logman00b44/KeyConnect/mechanical/pcb/previews/bottom.png

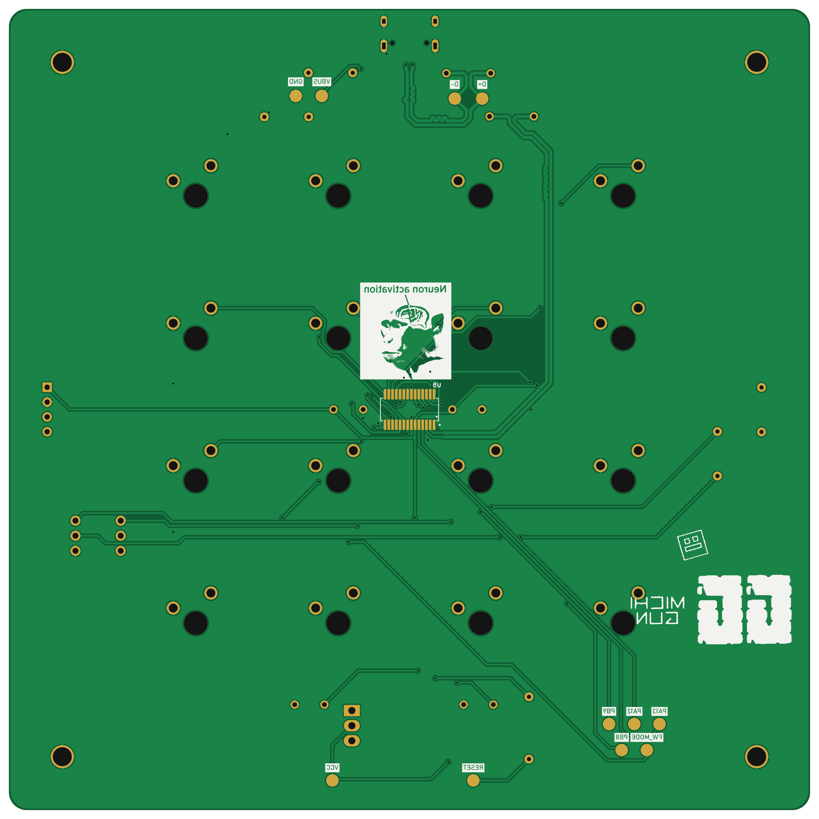
mechanical/pcb/previews/bottom.png
