logman00b44/KeyConnect/mechanical/pcb/previews/top.png

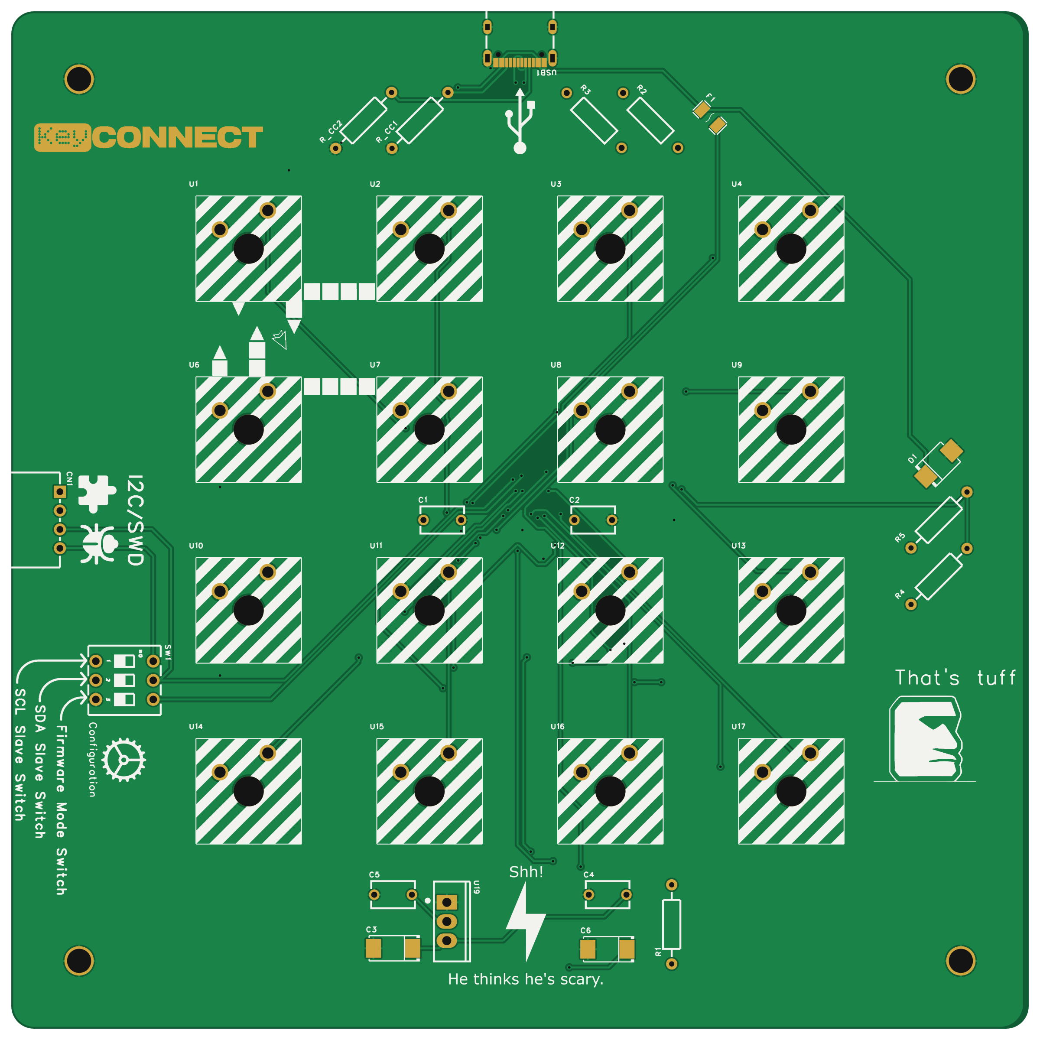
mechanical/pcb/previews/top.png
