logman00b44/KeyConnect/hardware/bom/BOM_PCB2_1.md

| Designators | Qty | Value / Part | Footprint | LCSC | Mfr Part # |
|---|---|---|---|---|---|
| `C1 C5 C4 C2` | 4 | 100nF | CAP-TH_L5.8-W3.6-P5.0-D0.6 | [C5632426](https://www.lcsc.com/product-detail/C5632426.html) | 178MU0002 |
| `C6 C3` | 2 | 47uF | CAP-SMD_L6.0-W3.2-R-RD | [C506634](https://www.lcsc.com/product-detail/C506634.html) | 593D476X9010C2TE3 |
| `CN1` | 1 | ZX-XH2.54-4PWZ | CONN-TH_4P-P2.50_ZX-XH2.54-4PWZ | [C7429643](https://www.lcsc.com/product-detail/C7429643.html) | ZX-XH2.54-4PWZ |
| `D1` | 1 | SMBJ5.0A | SMB_L4.6-W3.6-LS5.4-RD | [C50087807](https://www.lcsc.com/product-detail/C50087807.html) | SMBJ5.0A |
| `F1` | 1 | 500mA/24V | F1206 | [C2984676](https://www.lcsc.com/product-detail/C2984676.html) | 500mA/24V |
| `GND VBUS VCC RESET PB9 PB8 PA12 FW_MODE PA13 D+ D-` | 11 | Test-Point | Test-Point-0.5mm | — |  |
| `R_CC2 R_CC1` | 2 | 5.1kΩ | RES-TH_BD2.3-L6.5-P10.50-D0.5 | [C714010](https://www.lcsc.com/product-detail/C714010.html) | MF1/4W-5.1KΩ±1%T52 |
| `R1` | 1 | 10kΩ | RES-TH_BD2.3-L6.5-P10.50-D0.5 | [C119347](https://www.lcsc.com/product-detail/C119347.html) | MF1/4W-10KΩ±1% T |
| `R2 R3` | 2 | 22Ω | RES-TH_BD2.4-L6.3-P10.30-D0.6 | [C1365706](https://www.lcsc.com/product-detail/C1365706.html) | CFR-25JB-52-22R |
| `R4 R5` | 2 | 4.7kΩ | RES-TH_BD2.3-L6.5-P10.50-D0.5 | [C119339](https://www.lcsc.com/product-detail/C119339.html) | MF1/4W-4.7KΩ±1% T |
| `SW1` | 1 | DSWB03LHGET | SW-TH_DSWB03LHGET | [C99420](https://www.lcsc.com/product-detail/C99420.html) | DSWB03LHGET |
| `U5` | 1 | CH32X035G8R6 | QSOP-28_L9.9-W3.9-P0.64-LS6.0-BL | [C49118551](https://www.lcsc.com/product-detail/C49118551.html) | CH32X035G8R6 |
| `U14 U6 U10 U1 U15 U11 U7 U2 U12 U3 U16 U8 U4 U17 U9 U13` | 16 | CherryMX | CherryMX_9.75u | — |  |
| `U19` | 1 | LM1117T-3.3 | TO-220-3_L10.0-W4.5-P2.54-L | [C498321](https://www.lcsc.com/product-detail/C498321.html) | LM1117T-3.3 |
| `USB1` | 1 | TYPE-C16PIN | USB-C-SMD_TYPE-C16PIN | [C393939](https://www.lcsc.com/product-detail/C393939.html) | TYPE-C16PIN |
