logman00b44/KeyConnect/hardware/exports/3D_PCB2_1_2026-10-18.step

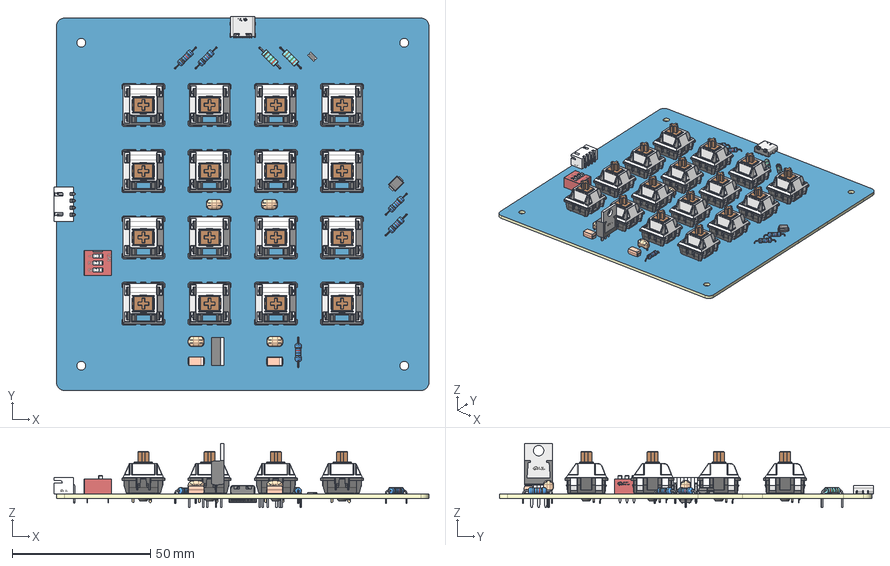
[picture p7: CAD file, 2026-10-18]
hardware/exports/3D_PCB2_1_2026-10-18.step
135.9 x 135.6 x 23.4 mm
Board~quLZ
TopCopper~quLZ
BottomCopper~quLZ
TopSilkscreen~quLZ
BottomSilkscreen~quLZ
TopFpcStiffener~quLZ
BottomFpcStiffener~quLZ
SMB_L4.6-W3.6-LS5.4-RD~SMB_L4.6-W3.6-LS5.4-RD~W26H
CONN-TH_4P-P2.50_ZX-XH2.54-4PWZ~CONN-TH_4P-P2.50_ZX-XH2.54-4PWZ~w89a
RES-TH_BD2.3-L6.5-P10.50-D0.5~RES-TH_D2.3-L6.5-P10.50~nUMX x 5
CAP-TH_L5.8-W3.6-P5.0-D0.6~CAP-TH_L5.8-W3.6-P5.0-D0.6~2mR1 x 4
F1206~F1206_L3.2-W1.7-H0.6~JZFH
CherryMX_9.75u~SW_Cherry_MX_Plate~TsvF x 16
USB-C-SMD_TYPE-C16PIN~USB-C-SMD_TYPE-C16PIN~rp8N
CAP-SMD_L6.0-W3.2-R-RD~CASE-C_L6.0-W3.2-H2.7~mIcH x 2
TO-220-3_L10.0-W4.5-P2.54-L~TO-220-3_L10.0-W4.5-P2.54-L~WQDO
QSOP-28_L9.9-W3.9-P0.64-LS6.0-BL~QSOP-28_L9.9-W3.9-P0.64-LS6.0-BL~1R3H
RES-TH_BD2.4-L6.3-P10.30-D0.6~RES-TH_BD2.4-L6.3-P10.30-D0.6~340k x 2
SW-TH_DSWB03LHGET~SW-TH_L9.1-W9.9-H5.4-P2.54-R~ZtNp
