logman00b44/KeyConnect/hardware/exports/shapr3d_export_2026-03-15_00h14m.step

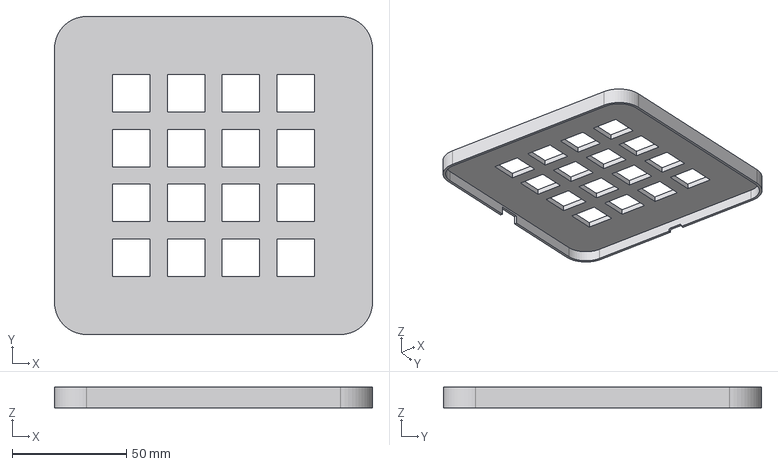
[picture p8: CAD file, 2026-10-18]
hardware/exports/shapr3d_export_2026-03-15_00h14m.step
139.0 x 139.0 x 9.00 mm
