logman00b44/KeyConnect/hardware/exports/shapr3d_export_2026-03-02_20h16m.step

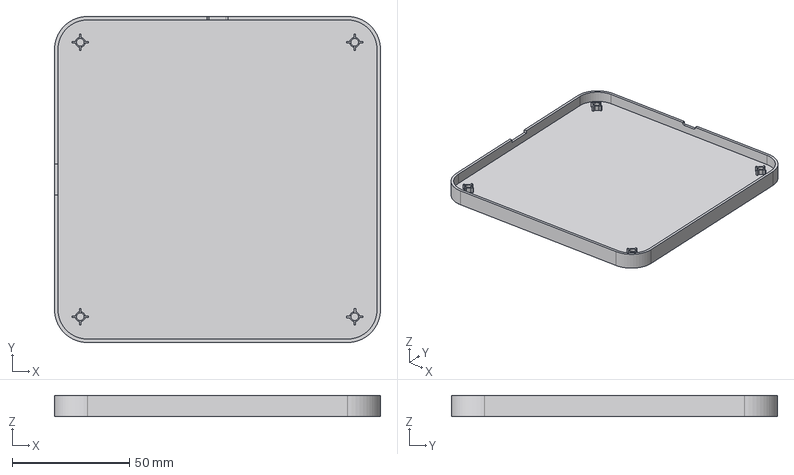
[picture p9: CAD file, 2026-10-18]
hardware/exports/shapr3d_export_2026-03-02_20h16m.step
139.0 x 139.0 x 9.00 mm
