logman00b44/KeyConnect/hardware/exports/shapr3d_export_2026-03-02_20h28m.obj

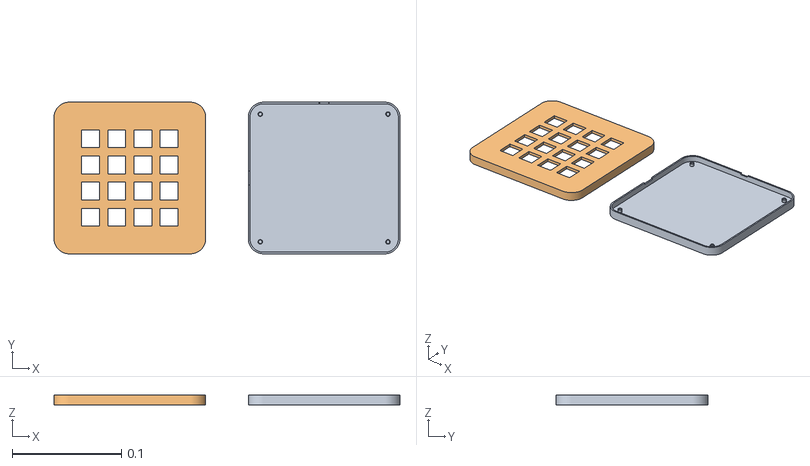
[picture p10: CAD file, 2026-03-02]
hardware/exports/shapr3d_export_2026-03-02_20h28m.obj
0.317 x 0.139 x 0.009
Bottom
Top
