logman00b44/KeyConnect/(list of files, cad)

Other CAD files:
hardware/exports/shapr3d_export_2026-03-02_20h28m.dwg
hardware/exports/shapr3d_export_2026-03-02_20h28m.dxf
