logman00b44/KeyConnect/(list of files, drawings)

Other design files:
hardware/pcb/PCB2_1.pcbdoc
hardware/schematic/1_P1.schdoc
hardware/schematic/2_Test Points.schdoc
