logman00b44/KeyConnect/(commit log)

2026-02-05 added Assembled 3d Model
2026-02-05 updated photos to new revision of minor pcb fix
2026-03-02 Added more details and 3d enclosure
    [1_P1.schdoc, 2_Test Points.schdoc, PCB2_1.pcbdoc, shapr3d_export_2026-03-02_20h16m.step, shapr3d_export_2026-03-02_20h28m.dwg, shapr3d_export_2026-03-02_20h28m.dxf, shapr3d_export_2026-03-02_20h28m.obj]
2026-10-18 Add CH32X035 firmware, host tools, licenses, and docs
    Bring in the KeyConnect R1 firmware sources (previously only on disk and
    never committed to any repository) plus the latest hardware export.
    Firmware (MIT):
    - main.c, fsusb.c/h, key_config.h, i2c_lcd.c/h, usb_config.h,
    funconfig.h, Makefile
    - HID feature-report configuration protocol (Report IDs 1-4)
    - driver/: Windows INF, hidapi CLI + device smoke test, WinUI 3 config app
    - prebuilt/main.{bin,elf,map} so boards can be flashed without a toolchain
    Also:
    - root README.md with board previews, specs and build/flash pointers
    - LICENSE (MIT, software) and LICENSE-hardware (CC BY-SA 4.0, hardware)
    - .gitignore for build output
    - docs/OSHWLa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
    [shapr3d_export_2026-03-02_20h16m.step, shapr3d_export_2026-03-15_00h14m.step]
2026-10-18 Add 2026-10-18 fabrication files, refreshed previews, and a real BOM
    Use the newly exported design data (EasyEDA Pro, 2026-10-18) to refresh the
    board imagery and publish the fabrication artifacts the docs had only promised.
    Previews (mechanical/pcb/previews):
    - Regenerate top.svg / bottom.svg from the current Gerbers with tracespace
    (much more detail than the previous revision's exports)
    - Add rasterised top.png / bottom.png at 2400 px
    - Re-render Assembled_View.png from the EasyEDA 3D model with Blender/Cycles,
    now correctly showing the top face and the 16 populated switches
    - Document how each preview is reproduced
    New hardware artifacts:
    - hardware/gerbers/ — full Gerber + drill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
    [3D_PCB2_1_2026-06-11.obj, BOM_PCB2_1.csv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]
2026-10-18 Rework board previews: Gerber-accurate 2D composites + real 3D renders
    The previous previews were default tracespace board renders, which paint the
    copper as light grey over a washed-out mask and leave a grey FR-4 rim around the
    board edge, and the 3D view was a June export with blown-out lighting.
    2D previews (mechanical/pcb/previews/top|bottom.svg + .png)
    - Composite the fabrication layers by hand from the tracespace per-layer SVGs:
    soldermask over laminate, copper under the mask, silkscreen, mask openings
    (exposed pad finish) and finally the drills, all clipped to a generated
    135 mm rounded rectangle (r = 3 mm) so the board edge is clean.
    - Re-anchor every layer into one shared coo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
    [3D_PCB2_1_2026-06-11.obj, 3D_PCB2_1_2026-10-18.step]
2026-10-19 Clear switch housings, red DIP switch, and lighter previews
    Render tweaks (mechanical/pcb/previews)
    - Switch housings are now translucent (alpha 0.35, frosted) so the hatched
    silkscreen squares underneath stay visible through them.
    - The DIP/slide switch is picked out in solid red.
    - Both are done by material name from the STEP export (`switch`, `slide`), so
    nothing else is re-coloured and the board artwork still comes only from the
    Gerbers.
    - Rendered at 1800x1350 and published at 1280 px wide with the alpha bounding box
    trimmed: Assembled_View.png 2.2 MB -> 0.96 MB, Assembled_View_Bottom.png
    1.6 MB -> 0.61 MB. The 2D PNGs drop to 2400 px (490/400 KB -> 370/300 KB).
    - Re-rendered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
2026-10-19 Model the switches like real clear-housing Cherry MX parts
    The clear housings were letting the board artwork show straight through them,
    which made the switch interior read as a black hole. Each switch model is built
    from separate solids, so split them by connectivity and classify each part by
    its bounding box:
    top housing shell -> clear (alpha 0.40)
    stem (the "+") -> solid red, like a Cherry MX Red
    bottom housing/spring/contacts -> near-black
    That is what a clear-housing Cherry MX looks like from the outside, and it also
    fixes the two things that read as wrong: no more black void through the middle,
    and no board print showing through the shell. The DIP s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
